Martix2222/Pullcopter-VX/README.md

# Pullcopter-VX
This is my take on a very fun 3D printed toy that shoots propellers by pulling a cord.
