Martix2222/Pullcopter-VX/CAD/Main assembly/Full assembly.STEP

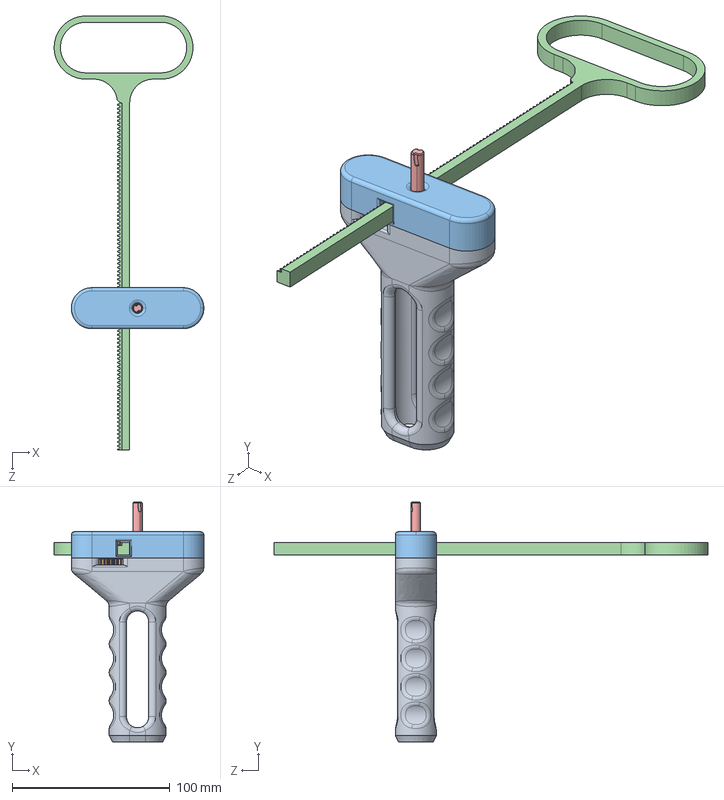
[picture p1: CAD file, 2025-11-09]
CAD/Main assembly/Full assembly.STEP
94.9 x 152.0 x 275.0 mm
Handle
Large gear with shaft
Top handle part
Pull cord
Small gear with shaft
