Martix2222/Pullcopter-VX/CAD/Main assembly/Print files/STL/Full assembly - Small gear with shaft-2.STL

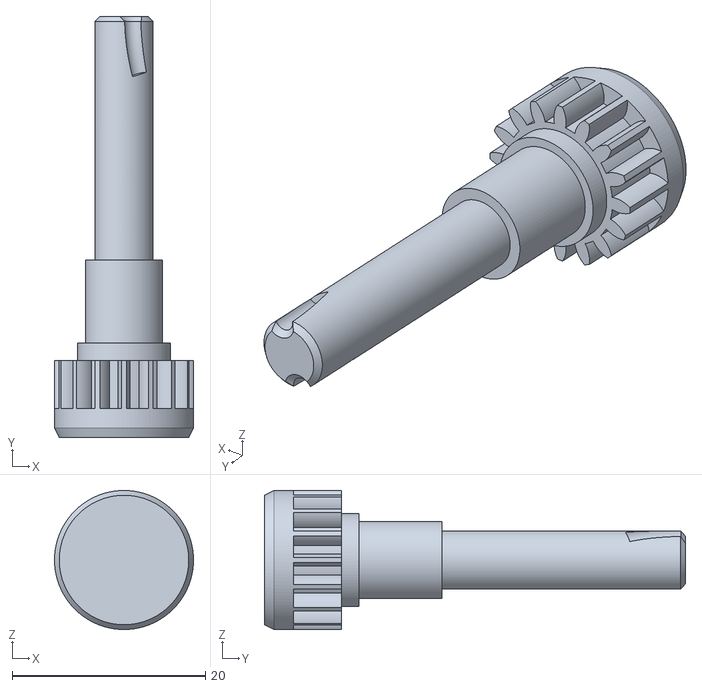
[picture p2: CAD file, 2025-11-01]
CAD/Main assembly/Print files/STL/Full assembly - Small gear with shaft-2.STL
14.4 x 43.6 x 14.4
