Martix2222/Pullcopter-VX/CAD/Main assembly/Print files/STL/Full assembly - Pull cord-1.STL

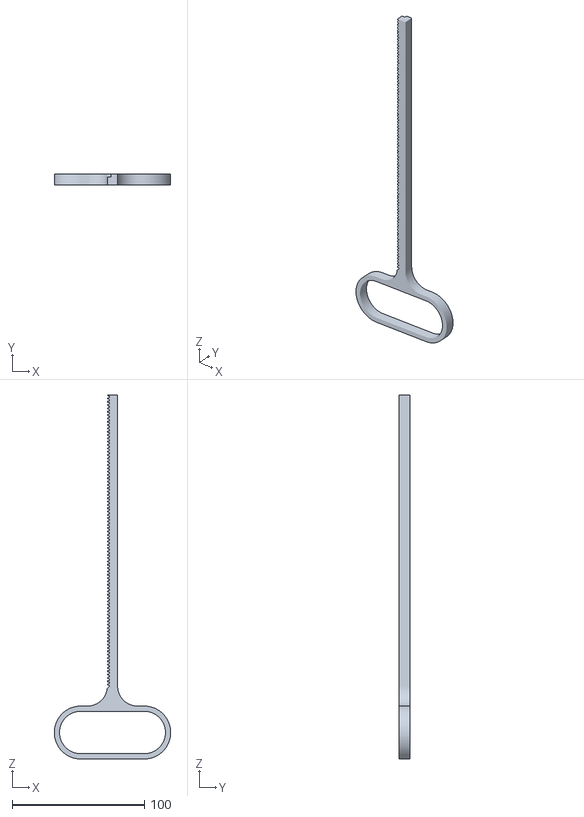
[picture p3: CAD file, 2025-11-01]
CAD/Main assembly/Print files/STL/Full assembly - Pull cord-1.STL
88.0 x 8.00 x 275.0
