Martix2222/Pullcopter-VX/CAD/Main assembly/Print files/STL/Full assembly - Top handle part-1.STL

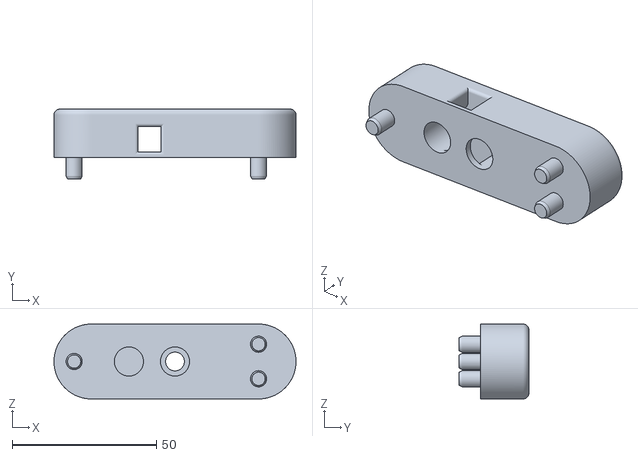
[picture p4: CAD file, 2025-11-01]
CAD/Main assembly/Print files/STL/Full assembly - Top handle part-1.STL
84.0 x 24.2 x 26.0
