Martix2222/Pullcopter-VX/CAD/Main assembly/Print files/STL/Full assembly - Large gear with shaft-1.STL

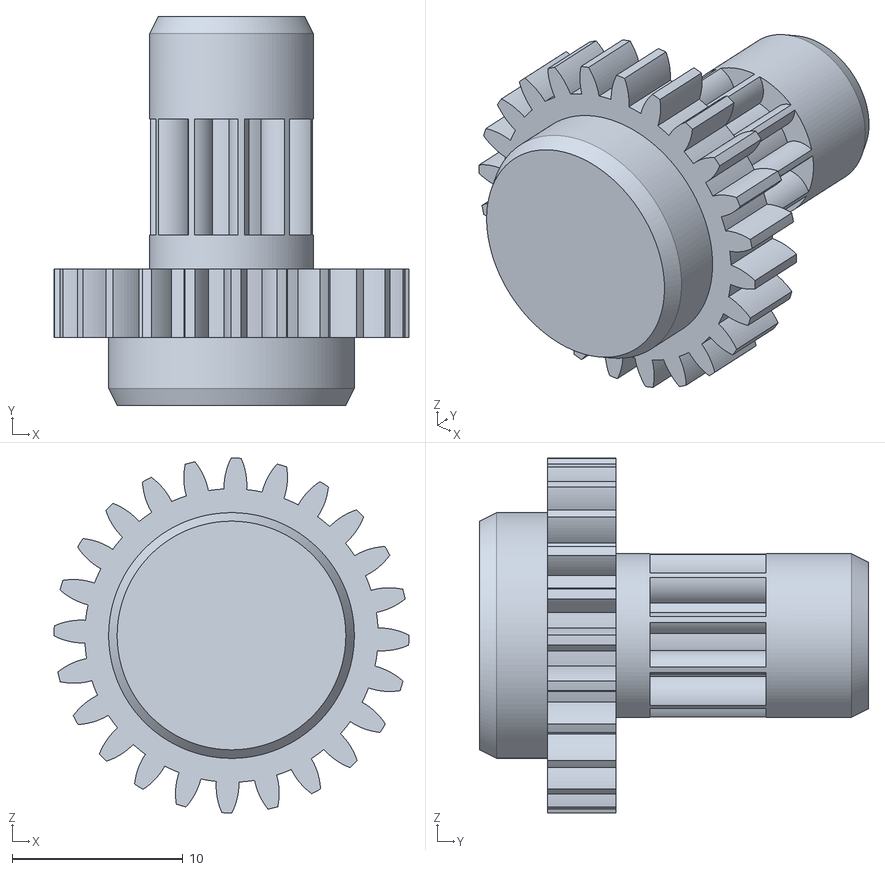
[picture p5: CAD file, 2025-11-01]
CAD/Main assembly/Print files/STL/Full assembly - Large gear with shaft-1.STL
20.8 x 22.8 x 20.8
