Martix2222/Pullcopter-VX/CAD/Main assembly/Print files/STL/Full assembly - Handle-1.STL

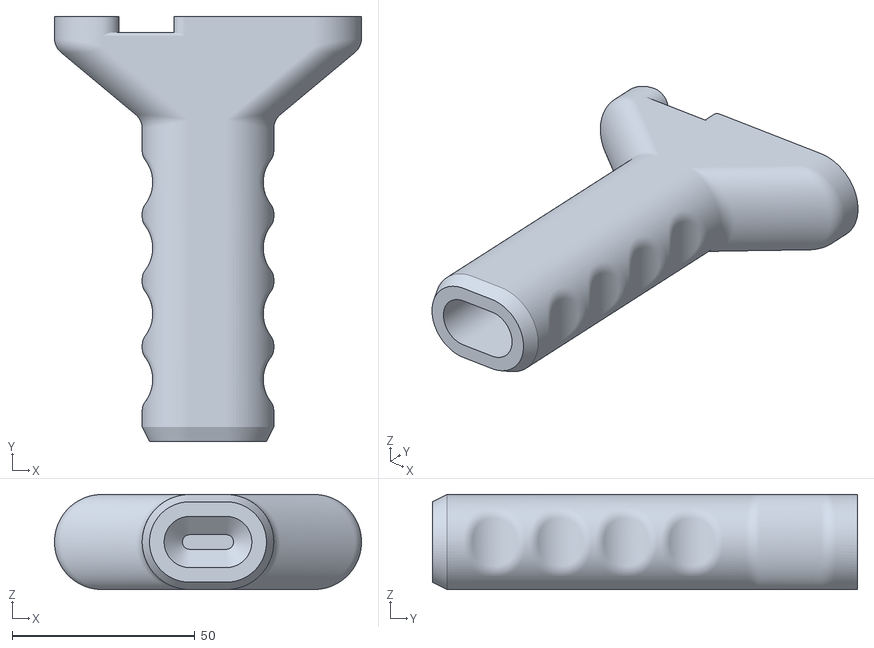
[picture p6: CAD file, 2025-11-01]
CAD/Main assembly/Print files/STL/Full assembly - Handle-1.STL
84.0 x 116.4 x 26.0
