Martix2222/Pullcopter-VX/CAD/Propeller/Propeller.STEP

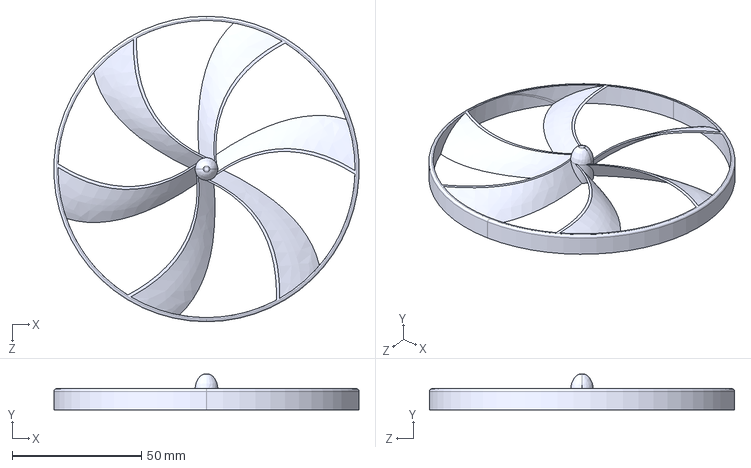
[picture p7: CAD file, 2025-10-30]
CAD/Propeller/Propeller.STEP
118.0 x 13.9 x 118.2 mm
