Martix2222/Pullcopter-VX/CAD/Main assembly/Handle/Handle.STEP

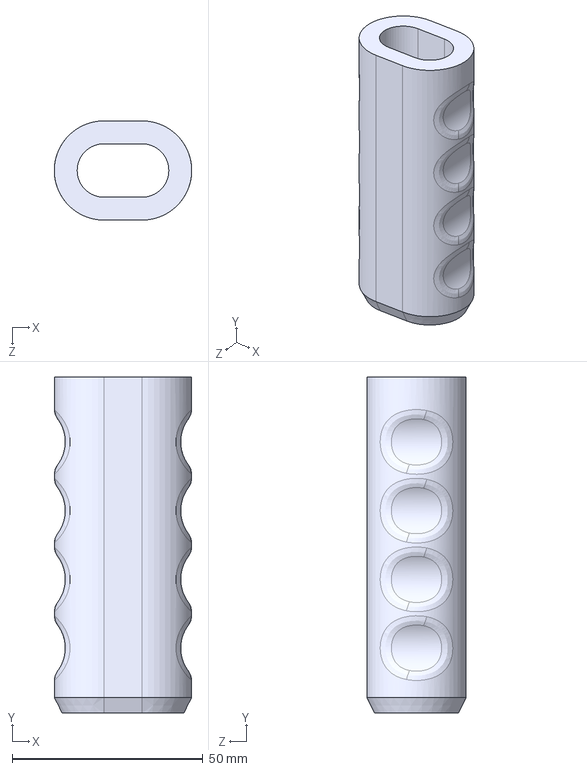
[picture p8: CAD file, 2025-10-26]
CAD/Main assembly/Handle/Handle.STEP
36.0 x 88.0 x 26.0 mm
