Martix2222/Pullcopter-VX/(list of files, cad)

Other CAD files:
CAD/Main assembly/Gears/Small gear with shaft.SLDPRT
CAD/Main assembly/Handle/Top handle part.SLDPRT
CAD/Main assembly/Gears/Large gear with shaft.SLDPRT
CAD/Main assembly/Pull cord.SLDPRT
CAD/Main assembly/Gears/Pull cord gear.SLDPRT
CAD/Main assembly/Full assembly.SLDASM
CAD/Main assembly/Handle/Handle.SLDPRT
CAD/Main assembly/Handle/Handle.STL
CAD/Main assembly/Print files/Full assembly.3mf
CAD/Propeller/Propeller.SLDPRT
CAD/Propeller/Propeller.STL
