Martix2222/Pullcopter-VX/JOURNAL.md

<!--
  ===================    !!READ THIS NOTICE!!   ====================
  DO NOT edit this file manually. Your changes WILL BE OVERWRITTEN!
  This journal is auto generated and updated by Hack Club Blueprint.
  To edit this file, please edit your journal entries on Blueprint.
  ==================================================================
-->

## 10/26/2025 - Created a custom propeller  

The idea for this project came from the many versions of the Pullcopter that can be found find online. However, I couldn't really find any good ones that were using the "pulling" mechanism combined with a gear reduction system to maximize the propeller speed. So I decided to make my own.
Today, I started by designing a custom propeller. I took inspiration from a few online projects and here is the current result in SolidWorks:
feature tree
propeller preview
It took quite a lot of effort, as SolidWorks sometimes just refuses to work unless you select the same thigs in a magically specific order (which took me a lot of time to figure out). However, I am currently pretty happy with it. I tried to give it a lot of thought and hopefully thanks to features like variable blade thickness (to improve lift), it will either fly really well or not at all, I'll have to see... Now, I'll start working on the gear reduction system and on the body so that I can test the propeller and improve it later based on its properties in flight.

Also, the bottom of the propeller, which attaches to the rotary shaft and should let go once the shaft stops putting in additional energy looks like this:
propeller shaft hole  

## 10/27/2025 - Fixed the propeller and started working on the gears  

So, firstly, I fixed some problems with the thickness of the propeller blades. (There were some places where its blades were too thick which I did not notice before)
I also made quite a lot of progress on the gear reduction mechanism. It currently looks like this:


It took me a lot of time to figure out how gears work in SolidWorks (fortunately a few tutorials helped) and how to make them into a proper assembly.

The last thing I worked on is the handle. I will now have to figure out how to incorporate all the mechanisms into it, such that it can then be printed and assembled easily:

(It currently really currently is just the handle part)

## 10/28/2025 - Everything broke  

Today, SolidWorks just decided to refuse to work and broke everything inside the gear assembly. 

I tried fixing it but it just made things worse. So I decided to redo everything in a new assembly. The upside of this is that it allowed me to reconsider some things and I will include the handle in the assembly, so the whole body including the handle and the gearbox will be inside of one assembly now. I am also moving much faster now because I already know what to do and how to do it.

Furthermore, I printed and tested the propeller (It is compatible with another pullcopter I found online so that I could test it before I made my version of the body) and I decided to make the curvature of the blades less aggressive, because they were just too thick and it seemed to have worse properties overall.


## 10/29/2025 - Further improved the propeller  

I reduced the size of the propeller and reduced the mass of its blades by making them thinner. Now, I am pretty happy with it. It is also easier to print now.
20251029_194443(1)

## 10/31/2025 - Finished a first usable version  

I finally finished a first usable version of the body with the gearbox! Here it is:


The gear ratio of the gearbox is 30:10 or 3:1


Since the entry in which I wrote that I will have to redo everything I actually did do so and I probably figured out the nature of what I did such that I can hopefully prevent the assembly from breaking in the future. I also chose a different style of assembling the body, which I will have to test now. The two parts should just snap together around the gearbox. In total there are 6 printable parts in total (including the propeller). I will now have to test how they come together and adjust them if necessary.  

## 11/1/2025 - I made some mistakes  

After printing and testing the top part of the handle with the gears and the pull cord, I realized I made a few mistakes. Firstly, I added this ridge to the shaft with the smaller wheel:


This was necessary to prevent the shaft from moving up and down inside the assembly.

Secondly I realized i incorrectly positioned the pull cord relative to the wheel it was supposed to rotate. I was too close and the Sketch it was based on was improperly defined so I had to fix it.


Lastly, I have decreased the gear ratio because I found that 3:1 is just too extreme. The force with which I had to pull on the cord was just really high so I will try a ratio of 24:16 or 3:2 which should be much better.
The old version:
20251101_165243(1)

The new version:


I have also fixed some definitions inside the sketches to make the resizing process a bit easier if I decide for a different gear ratio again in the future. Now, I will have to print everything again and see whether is feels and fits better.

Also, I just realised that the ridge I added is now useless since I made the gear on the shaft larger, so it in holds the shaft in place by itself, but I will keep the ridge there anyway, because it does not interfere with anything.
