Martix2222/Pullcopter-VX/(commit log)

2025-10-26 Add a first version of the propeller
    [Propeller.SLDPRT, Propeller.STL]
2025-10-26 Remove testing features and improve prop wings
    [Propeller.SLDPRT, Propeller.STL]
2025-10-26 Add Propeller.STEP version
    [Propeller.SLDPRT, Propeller.STEP]
2025-10-26 Add folders to organize CAD files
    [Propeller.SLDPRT, Propeller.STEP, Propeller.STL]
2025-10-26 Initial commit for the handle
    [Handle.SLDPRT, Handle.STEP, Handle.STL]
2025-10-26 Fix propeller blade thickness
    [Propeller.SLDPRT, Propeller.STEP, Propeller.STL]
2025-10-26 Finish the holding part of the handle
    [Handle.SLDPRT]
2025-10-26 First commit of the gear assembly
    [Gear assembly.SLDASM, large gear shaft adapter.SLDPRT]
2025-10-27 Improve and simplify propeller geometry
    [Propeller.SLDPRT, Propeller.STEP, Propeller.STL]
2025-10-27 Fix rebuild errors in gear assembly
    [Gear assembly.SLDASM]
2025-10-27 The gear assembly is broken, TO BE REMOVED
    [Gear assembly - borked.SLDASM]
2025-10-27 Start work on a new fixed gear assembly
    [Gear assembly - fixed.SLDASM, Handle.SLDPRT]
2025-10-29 Reduced the mass of the propeller blades
    [Propeller.SLDPRT, Propeller.STEP, Propeller.STL]
2025-10-30 Improved the propeller mounting point design
    [Propeller.SLDPRT, Propeller.STEP, Top handle part.SLDPRT]
2025-10-30 Made a first complete version of the body assembly
    [Full assembly.SLDASM, Gear assembly - borked.SLDASM, Gear assembly - fixed.SLDASM, Gear assembly.SLDASM, Handle.SLDPRT, Handle.STEP, Handle.STL, Large gear.SLDPRT]
2025-10-31 Finalize the pull cord
    [Pull cord.SLDPRT]
2025-10-31 Finalized the assembly and simplified it
    [Full assembly.SLDASM, Large gear with shaft.SLDPRT, Large gear.SLDPRT, Pull cord gear.SLDPRT, Small gear with shaft.SLDPRT, Top handle part.SLDPRT]
2025-10-31 Add a chamfer to the inside of the handle
    [Full assembly.SLDASM, Handle.SLDPRT, Large gear with shaft.SLDPRT, Top handle part.SLDPRT]
2025-10-31 Add exported print files
    [Full assembly - Handle-1-1.STL, Full assembly - Handle-1.STL, Full assembly - Large gear with shaft-1-1.STL, Full assembly - Large gear with shaft-1.STL, Full assembly - Pull cord-1-1.STL, Full assembly - Pull cord-1.STL, Full assembly - Small gear with shaft-1-1.STL, Full assembly - Small gear with shaft-1.STL]
2025-10-31 Add a 3mf file for printing and clean up
    [Full assembly - Handle-1-1.STL, Full assembly - Handle-1.STL, Full assembly - Large gear with shaft-1-1.STL, Full assembly - Pull cord-1-1.STL, Full assembly - Small gear with shaft-1-1.STL, Full assembly - Small gear with shaft-1.STL, Full assembly - Top handle part-1-1.STL, Full assembly.3mf]
2025-11-01 Fixed pull cord position and reduced gear ratio
    [Full assembly - Handle-1.STL, Full assembly - Large gear with shaft-1.STL, Full assembly - Pull cord-1.STL, Full assembly - Small gear with shaft-1.STL, Full assembly - Small gear with shaft-2.STL, Full assembly - Top handle part-1.STL, Full assembly.3mf, Full assembly.SLDASM]
2025-11-01 Fixed the pull cord position (again)
    [Full assembly - Pull cord-1.STL, Full assembly - Small gear with shaft-2.STL, Full assembly - Top handle part-1.STL, Full assembly.3mf, Full assembly.SLDASM, Full assembly.STEP, Large gear with shaft.SLDPRT, Small gear with shaft.SLDPRT]
2025-11-09 Made the handle more lightweight
    [Full assembly.3mf, Full assembly.SLDASM, Full assembly.STEP, Handle.SLDPRT, Large gear with shaft.SLDPRT, Small gear with shaft.SLDPRT, Top handle part.SLDPRT]
